golanovas/Diplom-Help/02_Аннотация.docx

АННОТАЦИЯ

Выпускная квалификационная работа посвящена разработке устройства защиты помещения от затопления и протечек, которое позволяет пользователю предотвращать негативные последствия несанкционированного выливания воды. Также оно оповещает пользователя о выполненных операциях, позволяя своевременно реагировать на возникшую протечку.

Так же работа включает в себя комплекс документов по разработке устройства. Содержание графической части: схема электрическая структурная, схема электрическая принципиальная, алгоритм работы устройства, чертеж печатной платы, сборочный чертеж электронной ячейки, сборочный чертеж устройства, спецификации, схемы сборки. В заключении представлены выводы о проделанной работе и соответствии разработанного устройства техническому заданию.

Ключевые слова: протечка, затопление, оповещение, схемотехническое проектирование, конструкторское проектирование, технологическое проектирование.

ABSTRACT

The final qualifying work is devoted to the development of a device for protecting a room from flooding and leaks, which allows the user to prevent the negative consequences of unauthorized pouring of water. It also notifies the user of completed operations, allowing them to respond in a timely manner to a leak.

The work also includes a set of documents on the development of the device. The contents of the graphic part are: an electrical structural diagram, an electrical schematic diagram, an algorithm for the operation of the device, a drawing of a printed circuit board, an assembly drawing of an electronic cell, an assembly drawing of the device, specifications, assembly diagrams. In conclusion, the conclusions about the work done and the compliance of the developed device with the technical specification are presented.

Keywords: leakage, flooding, notification, circuit engineering, design engineering, technological design.
