golanovas/Diplom-Help/01_Титульный лист.docx

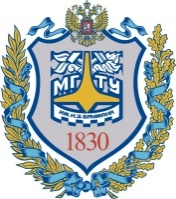
[picture p1: figure]
Gerb-BMSTU_01

| Министерство науки и высшего образования Российской Федерации Федеральное государственное бюджетное образовательное учреждение высшего образования «Московский государственный технический университет имени Н.Э. Баумана (национальный исследовательский университет)» (МГТУ им. Н.Э. Баумана)

ФАКУЛЬТЕТ Информатика и системы управления .

КАФЕДРА Проектирование и технология производства электронной аппаратуры .

РАСЧЕТНО-ПОЯСНИТЕЛЬНАЯ ЗАПИСКА

К ВЫПУСКНОЙ КВАЛИФИКАЦИОННОЙ РАБОТЕ

НА ТЕМУ:

Устройство защиты помещения от затопления и протечек

Студент ИУ4-71Б _________________ С.А. Глухов .

(Группа) (Подпись, дата) (И.О.Фамилия)

Руководитель ВКР _________________ А.Е. Курносенко .

(Подпись, дата) (И.О.Фамилия)

Консультант _________________ ____________________

(Подпись, дата) (И.О.Фамилия)

Консультант _________________ ____________________

(Подпись, дата) (И.О.Фамилия)

Нормоконтролер _________________ ____________________

(Подпись, дата) (И.О.Фамилия)

2024 г.
