golanovas/Diplom-Help/03_Содержание.docx

СОДЕРЖАНИЕ

УСЛОВНЫЕ ОБОЗНАЧЕНИЯ, СОКРАЩЕНИЯ И ЬЕРМИНЫ

ВВЕДЕНИЕ

1. ТЕХНИКО-ЭКОНОМИЧЕСКОЕ ОБОСНОВАНИЕ РАЗРАБОТКИ УСТРОЙСТВА ЗАЩИТЫ ПОМЕЩЕНИЯ ОТ ЗАТОПЛЕНИ И ПРОТЕЧЕК
  1.1. Анализ существующих на рынке устройств
  1.2. Анализ необходимых функций разрабатываемого устройства
  1.3. Анализ характеристик разрабатываемого устройства

Выводы

2. СХЕМОТЕХНИЧЕСКОЕ ПРОЕКТИРОВАНИЕ ЭЛЕКТРОННОЙ ЯЧЕЙКИ УСТРОЙСТВА ЗАЩИТЫ ПОМЕЩЕНИЯ ОТ ЗАТОПЛЕНИЯ И ПРОТЕЧЕК
  2.1. Разработка схемы электрической структурной электронной ячейки устройства защиты помещения от затопления и протечек
  2.2. Разработка схемы электрической принципиальной электронной ячейки устройства защиты помещения от затопления и протечек
  2.3. Расчёт потребляемой устройством защиты помещения от затопления и протечек мощности
  2.4. Выбор и анализ элементной базы устройства защиты помещения от затопления и протечек
  2.5. Выбор и анализ элементной базы устройства защиты помещения от затопления и протечек

Выводы

3. РАЗРАБОТКА ПРОГРАММНОГО ОБЕСПЕЧЕНИЯ УСТРОЙСТВА ЗАЩИТЫ ПОМЕЩЕНИЯ ОТ ЗАТОПЛЕНИЯ И ПРОТЕЧЕК
  3.1. Постановка задач разработки программного обеспечения устройства защиты помещения от затопления и протечек
  3.2. Разработка диаграммы состояний устройства защиты помещения от затопления и протечек
  3.3. Разработка диаграммы вариантов использования устройства защиты помещения от затопления и протечек
  3.4. Разработка временной диаграммы GPIO выводов микроконтроллера устройства защиты помещения от затопления и протечек
  3.5. Разработка алгоритма работы устройства защиты помещения от затопления и протечек

Выводы

4. КОНСТРУКТОРСКОЕ ПРОЕКТИРОВАНИЕ УСТРОЙСТВА ЗАЩИТЫ ПОМЕЩЕНИЯ ОТ ЗАТОПЛЕНИЯ И ПРОТЕЧЕК
  4.1. Выбор электрических соединений устройства защиты помещения от затопления и протечек
  4.2. Выбор материалов печатной платы электронной ячейки устройства защиты помещения от затопления и протечек
  4.3. Расчёт параметров элементов проводящего рисунка печатной платы электронной ячейки устройства защиты помещения от затопления и протечек
  4.4. Разработка топологии печатной платы электронной ячейки устройства защиты помещения от затопления и протечек
  4.5. Проектирование электронной ячейки устройства защиты помещения от затопления и протечек
  4.6. Выбор аккумуляторов устройства защиты помещения от затопления и протечек
  4.7. Выбор конструкции и материала корпуса устройства защиты помещения от затопления и протечек
  4.8. Выбор механических соединений устройства защиты помещения от затопления и протечек
  4.9. Выбор механических соединений устройства защиты помещения от затопления и протечек
  4.10. Проектирование устройства защиты помещения от затопления и протечек
  4.11. Анализ теплового режима
  4.12. Анализ механических воздействий
  4.13. Расчёт надёжности

Выводы

5. ТЕХНОЛОГИЧЕСКОЕ ПРОЕКТИРОВАНИЕ УСТРОЙСТВА ЗАЩИТЫ ПОМЕЩЕНИЯ ОТ ЗАТОПЛЕНИЯ И ПРОТЕЧЕК
  5.1. Анализ конструкции устройства защиты помещения от затопления и протечек
  5.2. Анализ сборочного состава электронной ячейки устройства защиты помещения от затопления и протечек
  5.3. Анализ сборочного состава устройства защиты помещения от затопления и протечек
  5.4. Разработка схемы сборки устройства защиты помещения от затопления и протечек
  5.5. Расчёт и анализ такта выпуска устройства защиты помещения от затопления и протечек
  5.6. Разработка маршрута сборки устройства защиты помещения от затопления и протечек

Выводы

6. ИССЛЕДОВАТЕЛЬСКИЕ ИСПЫТАНИЯ ОПЫТНОГО ОБРАЗЦА УСТРОЙСТВА ЗАЩИТЫ ПОМЕЩЕНИЯ ОТ ЗАТОПЛЕНИЯ И ПРОТЕЧЕК
  6.1. Постановка задач исследовательских испытаний опытного образца устройства защиты помещения от затопления и протечек
  6.2. Исследование работоспособности опытного образца устройства защиты помещения от затопления и протечек при питании от сети и аккумуляторов
  6.3. Исследование стабильности номиналов питания опытного образца устройства защиты помещения от затопления и протечек
  6.4. Исследование корректности алгоритма работы опытного образца устройства защиты помещения от затопления и протечек
  6.5. Исследование работоспособности пользовательского интерфейса опытного образца устройства защиты помещения от затопления и протечек
  6.6. Исследование теплового режима опытного образца устройства защиты помещения от затопления и протечек

Выводы

ЗАКЛЮЧЕНИЕ

СПИСОК ИСПОЛЬЗОВАННЫХ ИСТОЧНИКОВ

ПРИЛОЖЕНИЕ А

ПРИЛОЖЕНИЕ Б

ПРИЛОЖЕНИЕ В
