golanovas/Diplom-Help/04_Условные обозначения, сокращения и термины.docx

# УСЛОВНЫЕ ОБОЗНАЧЕНИЯ, СОКРАЩЕНИЯ И ТЕРМИНЫ

ГОСТ – Государственный стандарт;

ДПП – Двухсторонняя печатная плата;

ЕСКД – Единая система конструкторской документации;

КМО – Компонент, монтируемый в отверстие;

КМП – Компонент, монтируемый на поверхность;

МК – Микроконтроллер;

ПО – Программное обеспечение;

ПП – Печатная плата;

РПЗ – Расчётно-пояснительная записка;

РТЗ – Расширенное техническое задание;

ТЗ – Техническое задание;

УЗПЗП – Устройство защиты помещения от затопления и протечек;

ЭРЭ – Электрорадиоэлементы;

ABS – Ударопрочная техническая термопластическая смола на основе сополимера акрилонитрила с бутадиеном и стиролом;
