golanovas/Diplom-Help/05_Введение.docx

ВВЕДЕНИЕ

Во время несанкционированного выливания большого объёма воды в помещении, которое может произойти как от протечки в водном контуре или незакрытого крана, так и от плохого состояния стен или крыши в загородных домах или складских помещениях, может быть нанесён существенный вред. Например, во время затоплений в многоквартирных домах, кроме затапливаемой квартиры страдает также помещения снизу.

Для предотвращения подобных случаев, необходимо наличие устройства, которое могло бы оповещать о случаях выливания воды, а также стараться ограничивать дальнейшее увеличение вылитого объёма.

Работа посвящена разработке устройства защиты помещения от затопления и протечек (УЗПЗП).

Актуальность работы заключается в востребованности разработки и внедрения доступного устройства, объединяющего в себе функции обнаружения вылитой воды, оповещение пользователя и устранения вылитой воды не только с помощью закрытия кранов между внешним и внутренним водяными контурами, но и удаление воды из внутреннего водяного контура.

Цель работы – разработать устройство, отслеживающее состояние датчиков протечки и реагирующее на появление вылитой воды. Устройство должно обладать компактными размерами, что обеспечит удобство его размещения в ограниченном пространстве, а также быть оснащённым механизмом или крепёжными элементами, позволяющими надёжно фиксировать его на вертикальной поверхности — например, на стене или перегородке. Такая конструкция позволит рационально использовать доступную площадь и обеспечит устойчивое положение устройства в рабочем состоянии. В качестве пользовательского интерфейса взаимодействия с устройством должен использоваться Telegram бот.

Для решения постановленной задачи были выполнены следующие работы:

- Проведение схемотехнического проектирования электронной ячейки УЗПЗП, в рамках которой разрабатываются: схема электрическая структурная и схема электрическая принципиальная;
- Разработка ПО микроконтроллера УЗПЗП, включающее в себя разработку алгоритма работы УЗПЗП, а также его реализацию с помощью программы на языке C++;
- Проведение конструкторского проектирования УЗПЗП, в рамках которого были разработаны топология печатная плата электронной ячейки, модель электронной ячейки, корпус и модель всего устройства. Также были проведены моделирования и расчёты тепловых режимов работы, механических воздействий и надёжности УЗПЗП;
- Проведение технологического проектирования УЗПЗП, в рамках которого были разработаны схема сборки и маршрут сборки устройства, а также рассчитаны такт выпуска и коэффициент технологичности электронной ячейки;
- Изготовление опытного образца УЗПЗП, а также проведение исследовательских испытаний для определения границ его работоспособности.

Исходными данными являются:

- ТЗ на выполнение ВКРБ;
- Календарный план выполнения ВКРБ.

Результатом работы является набор расчетной и графической документации. В ее состав входят: схема электрическая структурная (Э1), схема электрическая принципиальная ультразвукового сканера (Э3), перечень элементов (ПЭ3), алгоритм работы и его реализация в виде ПО для микроконтроллера, чертеж печатной платы ультразвукового сканера, сборочный чертеж электронной ячейки ультразвукового сканера, спецификация на электронную ячейку, сборочный чертёж УЗПЗП, спецификация УЗПЗП, опытный образец УЗПЗП, РПЗ.

Структура и объём работы. Работа состоит из шести разделов. В первом разделе обосновывается необходимость разработки УЗПЗП. Во втором разделе изложены результаты схемотехнического проектирования устройства. Третий раздел посвящён описанию программного обеспечения, разработанного для микроконтроллера УЗПЗП. В четвёртом разделе представлена конструкторская разработка УЗПЗП, включая моделирование и расчёт основных параметров его работы. Пятый раздел содержит результаты технологического проектирования устройства, а также описан разработанный технологический процесс его изготовления. Шестой раздел посвящён экспериментальному исследованию опытного образца УЗПЗП.
