golanovas/Diplom-Help/12_Заключение.docx

ЗАКЛЮЧЕНИЕ

В процессе выполнения выпускной квалификационной работы было проведено комплексное исследование и разработка устройства защиты помещения от затопления и протечек, включающее анализ технических требований, проектирование аппаратной и программной части, конструкторские и технологические расчёты, а также изготовление и экспериментальное исследование опытного образца.

На начальном этапе были определены основные функциональные требования к устройству, а также условия эксплуатации. Проведён обзор существующих аналогов, позволивший обосновать целесообразность создания нового решения, объединяющего функции обнаружения протечки, автоматического перекрытия воды, удаления остатков жидкости с помощью насоса и информирования пользователя через Telegram-бота.

В рамках схемотехнического проектирования разработаны электрическая структурная и принципиальная схемы электронной ячейки устройства. Был выполнен расчёт потребляемой мощности, произведён выбор элементной базы и проведён её анализ на соответствие заданным режимам работы.

Программное обеспечение микроконтроллера было реализовано на основе алгоритма, разработанного из диаграммы состояний, диаграммы вариантов использования и временных диаграмм выводов микроконтроллера. Это позволило обеспечить корректную работу всех функциональных узлов устройства, включая считывание показаний датчиков протечки и управление исполнительными механизмами.

На этапе конструкторского проектирования была разработана топология печатной платы, рассчитаны параметры проводящего рисунка и выбраны материалы для изготовления платы, соответствующие действующим стандартам. Также были определены конструктивные особенности устройства, включая выбор корпуса, способов крепления и механических соединений. Выполнены тепловой расчёт, расчёт на воздействие механических нагрузок и оценка надёжности, подтвердившие работоспособность УЗПЗП в условиях реальной эксплуатации.

Технологическое проектирование включало разработку маршрута и схемы сборки устройства, расчёт такта выпуска и коэффициента технологичности. Результаты показали возможность эффективного производства устройства в мелкосерийном режиме без значительных изменений в технологии.

В заключение был изготовлен опытный образец устройства, на котором проведены исследовательские испытания, подтвердившие его работоспособность при питании как от сети, так и от аккумуляторов. Проверена стабильность номиналов питания, корректность алгоритма работы, функционирование пользовательского интерфейса и тепловой режим устройства.

Все этапы проекта — от анализа требований до экспериментального подтверждения работоспособности — выполнены в соответствии с техническим заданием. Разработанное устройство защиты помещения от затопления и протечек полностью соответствует заявленным характеристикам.
