golanovas/Diplom-Help/13_Список литературы.docx

СПИСОК ИСПОЛЬЗОВАННЫХ ИСТОЧНИКОВ

1. ООО "Биосе". Автономный сигнализатор протечки воды [Электронный ресурс] . — URL: https://biose.ru/catalog/nasha_produktsiya/ avtonomnyy_signalizator_protechki_vody_biose.html (дата обращения: 05.04.2025).
2. Сиблинг — Датчик протечки [Электронный ресурс] . — Режим доступа: URL: https://sibling.ru/all/security/kontrol-protechki-100/datchik-protechki-108/datchik-protechki-89/ (дата обращения: 05.04.2025).
3. Нептун. Официальный сайт — [Электронный ресурс] . — Режим доступа: URL: https://neptunsale.ru/ (дата обращения: 05.04.2025).
4. Биосе — Блокиратор протечек воды «Акваблок Золушка» [Электронный ресурс] . — Режим доступа: URL: https://biose.ru/catalog/nasha_produktsiya/blokirator_protechek_ vody_akvablok_zolushka.html (дата обращения: 05.04.2025).
5. ГОСТ 15150–69. Машины, приборы и другие технические изделия. Исполнения для различных климатических районов. Категории, условия эксплуатации, хранения и транспортирования в части воздействия климатических факторов внешней среды. — М.: Издательство стандартов, 1969. — 24 с.
6. ГОСТ 2.701–2008. Единая система конструкторской документации. Схемы. Виды и типы. Общие требования к выполнению. — М.: Стандартинформ, 2008. — 11 с.
7. ГОСТ 2.702–2011. Единая система конструкторской документации. Правила выполнения электрических схем. — М.: Стандартинформ, 2011. — 13 с.
8. Монк, С. Электроника. Теория и практика : учебник / С. Монк ; пер. с англ. П. Шерц. — 4-е изд. — СПб. : БХВ-Петербург, 2018. — 1168 с. : ил.
9. Титце, У., Шенк, К. Полупроводниковая схемотехника : учебник / У. Титце, К. Шенк ; пер. с нем. — 12-е изд. — Том I. — М. : ДМК Пресс, [без года]. — 832 с. : ил.
10. Aerosemi Technology — MT3608: High Efficiency 1.2MHz 2A Step Up Converter [Электронный ресурс] : техническое описание. — Режим доступа: URL: https://static.chipdip.ru/lib/688/DOC045688395.pdf (дата обращения: 05.04.2025).
11. Хоровиц, П., Хилл, У. Искусство схемотехники. Том I : учебное пособие / П. Хоровиц, У. Хилл ; пер. с англ. — 3-е изд. — М. : Техносфера, 2021. — 768 с.
12. ГОСТ 19.701–90. Единая система программной документации. Схемы алгоритмов и программ. Обозначения условные графических примитивов. — М.: Издательство стандартов, 1990. — 26 с.
13. Пирогова, Е. В. Проектирование и технология печатных плат : учебник для вузов / Е. В. Пирогова. — М. : ФОРУМ : ИНФРА-М, 2005. — 559 с. : ил.
14. ГОСТ 53429–2009. Совместимость техническая электромагнитная. Устройства защиты от импульсных перенапряжений низковольтные. Требования и методы испытаний. — М.: Стандартинформ, 2010. — 24 с.
15. ГОСТ 9.301–86. Единая система защиты от коррозии и старения. Покрытия металлические и неметаллические неорганические. Общие требования и методы ускоренных испытаний на стойкость к коррозии. — М.: Издательство стандартов, 1986. — 23 с.
16. ГОСТ 14526–93. Системы автоматического пожарного оповещения. Классификация и общие технические требования. — М.: Издательство стандартов, 1993. — 17 с.
17. ГОСТ Р 54849–2011 (IPC-SM-840E:2010). Национальный стандарт Российской Федерации. Маска паяльная защитная для печатных плат. Общие технические условия. — М.: Стандартинформ, 2011. — 10 с.ГОСТ 18620–86. Электромонтажные изделия. Общие технические условия. — М.: Издательство стандартов, 1986. — 7 с.
18. ГОСТ 18620–86. Изделия электротехнические. Маркировка. — М.: Издательство стандартов, 1986. — 7 с.
19. ТУ 29-02-889–93. Краски трафаретные серии 45971 для невпитывающих поверхностей. Технические условия. — М., 1993. — 12 с.
20. ГОСТ 23752–79. Платы печатные. Общие технические условия. — М.: Госстандарт, 1979. — 16 с.
21. ГОСТ Р МЭК 61192-1–2010. Печатные узлы. Требования к качеству. Часть 1. Общие технические требования. — М.: Стандартинформ, 2011. — 18 с.
22. ГОСТ Р 59630–2021. Установка поверхностно-монтируемых изделий на печатные платы. Методы конструирования. — М.: Стандартинформ, 2021. — 12 с.
23. ГОСТ Р 59681–2021. Сборка и монтаж электронных модулей. Припои, флюсы для пайки, припойные пасты. Марки, состав, свойства и область применения. — М.: Стандартинформ, 2021. — 24 с.
24. ГОСТ Р МЭК 61192-2–2010. Печатные узлы. Требования к качеству. Часть 2. Поверхностный монтаж. — М.: Стандартинформ, 2011. — 20 с.
25. ГОСТ 29137–91. Формовка выводов и установка изделий электронной техники на печатные платы. Общие требования и нормы конструирования. — М.: Издательство стандартов, 1991. — 14 с.
26. ГОСТ Р 56427–2022. Электронные модули радиоэлектронных средств. Технические требования к выполнению технологических операций пайки при поверхностном монтаже, монтаже в сквозные отверстия и смешанном монтаже с применением бессвинцовой и традиционной технологий. — М.: Стандартинформ, 2022. — 16 с.
27. ТУ 2389-001-78983067-05. Пластины из полимерных материалов "PLASTIK-71". Технические условия. — [М.], 2005. — 8 с.
28. ГОСТ 16019–2001. Аппаратура сухопутной подвижной радиосвязи. Требования по стойкости к воздействию механических и климатических факторов и методы испытаний. — М.: Госстандарт, 2001. — 14 с.
