golanovas/Diplom-Help/Голанов А.С. ИУ4-82Б ВКРБ РТЗ.docx

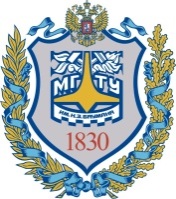
[picture p26: figure]
Gerb-BMSTU_01

| Министерство науки и высшего образования Российской Федерации Федеральное государственное автономное образовательное учреждение высшего образования «Московский государственный технический университет имени Н.Э. Баумана (национальный исследовательский университет)» (МГТУ им. Н.Э. Баумана)

ФАКУЛЬТЕТ «Информатика и системы управления» («ИУ»)

КАФЕДРА «Проектирование и технология производства электронной аппаратуры» («ИУ-4»)

РАСШИРЕННОЕ ТЕХНИЧЕСКОЕ ЗАДАНИЕ

НА ВЫПОЛНЕНИЕ ВЫПУСКНОЙ КВАЛИФИКАЦИОННОЙ РАБОТЫ БАКАЛАВРА:

Тема выпускной работы: «Система позиционирования в помещении»

Студент группы ИУ4-82Б А.С. Голанов

(Подпись, дата)

Руководитель ВКР А.В. Лавров

(Подпись, дата)

РАСШИРЕННОЕ ТЕХНИЧЕСКОЕ ЗАДАНИЕ

Настоящее техническое задание распространяется на разработку и исследование системы позиционирования в помещении на основе сверхширокополосной технологии, предназначенной для определения координат мобильного устройства в закрытых пространствах.

1. НАИМЕНОВАНИЕ, НАЗНАЧЕНИЕ И ОБЛАСТЬ ПРИМЕНЕНИЯ СИСТЕМЫ ПОЗИЦИОНИРОВАНИЯ В ПОМЕЩЕНИИ

1.1. Наименование изделия – система позиционирования в помещении

1.2. Система позиционирования в помещении предназначена для определения координат (x, y) мобильного устройства в реальном времени с использованием трех фиксированных базовых станций, на основе измерения времени пролета сигнала (ToF) в сверхширокополосном диапазоне.

1.3. Система позиционирования в помещении может быть использована для навигации роботов в складах, трекинга активов в логистике, мониторинга пациентов в здравоохранении или интеграции в IoT-системы для умных помещений.

2. ОСНОВАНИЕ ДЛЯ РАЗРАБОТКИ СИСТЕМЫ ПОЗИЦИОНИРОВАНИЯ В ПОМЕЩЕНИИ
  2.1. Настоящее техническое задание разработано в соответствии с заданием на квалификационную работу бакалавра.
3. ЦЕЛЬ И НАЗНАЧЕНИЕ РАЗРАБОТКИ СИСТЕМЫ ПОЗИЦИОНИРОВАНИЯ В ПОМЕЩЕНИИ
  3.1. Цель разработки – создание макетного образца изделия и комплект конструкторской и схемотехнической документации к нему.
  3.2. Система позиционирования должна иметь сетевое питание и работать в климатических условиях УХЛ4.1 по ГОСТ 15150-69.
4. ИСТОЧНИКИ РАЗРАБОТКИ АДАПТИВНОГО ТОРГОВОГО АВТОМАТА
  4.1. Анализ источников информации об аналогах по назначению.
5. ТЕХНИЧЕСКИЕ ТРЕБОВАНИЯ СИСТЕМЫ ПОЗИЦИОНИРОВАНИЯ В ПОМЕЩЕНИИ

5.1. Состав изделия системы позиционирования в помещении

5.1.1 Разрабатываемое устройство системы позиционирования в помещении состоит из электронной ячейки (для базовых станций и мобильного устройства) и корпуса.

5.1.2 Устройство предназначено для обмена сверхширокополосными сигналами между базовыми станциями и мобильным устройством, расчета расстояний по ToF и определения позиции с использованием алгоритма трилатерации.

5.2. Технические параметры системы позиционирования в помещении

Основные технические показатели изделия:

- напряжение питания управляющей платы: постоянное 3,3 В ± 5%;
- максимальный ток до 100 мА (в активном режиме);
- напряжение работы микроконтроллера 3,3 В ± 5%;
- диапазон рабочих температур: от 0°С до +40°С.
- максимальная дальность позиционирования — до 50 м;
- анализируемый частотный диапазон — 3,1–10,6 ГГц (полоса не менее 500 МГц);
- точность позиционирования — 10–30 см;
- количество базовых станций — 3 (фиксированные);
- количество режимов работы — до 2 (стандартный и энергосберегающий). Также устройство должно иметь возможность вывода данных через USB-интерфейс для конфигурации и мониторинга.

5.3. Требования к надежности системы позиционирования в помещении

Вероятность безотказной работы составляет 0,95 за время 10000 ч. Установленный срок службы изделия – 2 года.

5.4. Требования к уровню унификации и стандартизации

Требования к уровню унификации и стандартизации не предъявляются.

5.5. Конструктивные требования к системе позиционирования в помещении

5.5.1 Разрабатываемое устройство состоит из двухсторонней печатной платы с ЭРЭ и ИЭТ. Габариты базовой станции не более 100×100×50 мм, габариты мобильного устройства не более 80×60×30 мм, общая масса не более 0,2 кг.

5.5.2 Устройство питается от литий-ионного аккумулятора на 3,3 В или внешнего источника, подключенного через USB Type-C.

5.6. Условия эксплуатации системы позиционирования в помещении

Условия эксплуатации устройства соответствуют стационарной электронной аппаратуре для работы в закрытых отапливаемых и/или вентилируемых помещениях. Разрабатываемая система позиционирования в помещении должна соответствовать требованиям технического задания при воздействии следующих условий:

1. Условия эксплуатации в части воздействия механических факторов внешней среды: a) вибрация:
- диапазон частот: 20...4000 Гц;
- максимальное ускорение: 0.5g;
- длительность ударного импульса: 10 мс;
- амплитуда ускорения ударного импульса: 10g.
2. Климатические условия эксплуатации:

a) климатическое исполнение изделия: УХЛ4.1 по ГОСТ 15150-69;

b) температура воздуха при эксплуатации: от 0°С до +40°С;

c) атмосферное давление не превышает: 105 кПа;

d) Влажность воздуха: не более 80% при 25 °С.

5.7. Требования к составным частям, сырью и исходным материалам

Не предъявляются.

5.8. Требования к упаковке, маркировке, транспортированию и хранению системы позиционирования в помещении

Транспортирование упакованных устройств производиться любым видом транспорта. Транспортирование может производиться в закрытых железнодорожных вагонах или контейнерах, автомашинах, отапливаемых и герметизированных отсеках самолетов при соблюдении требований хранения настоящего ТЗ.

1. Условия транспортировки в части воздействия:

a) Механических нагрузок - группе "С" по ГОСТ23216-78;

b) Климатических факторов - группе 2 ("С") по ГОСТ 15150-69.

2. Условия хранения в части воздействия климатических факторов: группе 1 ("Л") по ГОСТ 15150-69. Система позиционирования в помещении должна храниться в сухом помещении. В помещении для хранения не должно быть паров кислот и щелочей, а также газов, вызывающих коррозию и разрушающих изоляцию.

5.9. Требования к патентной чистоте

Патентная чистота системы позиционирования в помещении должна быть обеспечена в отношении Российской федерации и стран СНГ.

6. ЭКОНОМИЧЕСКИЕ ПОКАЗАТЕЛИ СИСТЕМЫ ПОЗИЦИОНИРОВАНИЯ В ПОМЕЩЕНИИ

6.1. По сравнению с источниками разработки предлагаемое изделие имеет ряд экономических преимуществ:

- используются более распространенные и дешевые ЭРЭ;
- компактный размер;
- низкое энергопотребление.
7. ТРЕБОВАНИЯ ПО ТЕХНИКЕ БЕЗОПАСНОСТИ И ЭКОЛОГИЧЕСКОЙ ЗАЩИТЕ

7.1. Разрабатываемое изделие при эксплуатации должно обеспечивать безопасность обслуживающего персонала от поражения электрическим током согласно ГОСТ Р 51350-99.

7.2. Требования по охране природы не предъявляются, так как при изготовлении, эксплуатации, транспортировании, хранении, утилизации устройства отсутствуют вредные воздействия на элементы окружающей среды – воздух, воду, почву, недра, растительный и животный мир.

8. ПОРЯДОК КОНТРОЛЯ И ПРИЁМКИ СИСТЕМЫ ПОЗИЦИОНИРОВАНИЯ В ПОМЕЩЕНИИ

8.1 Для приемки предоставляется один опытный образец системы позиционирования в помещении, эксплуатационная документация, методика приемных испытаний, согласованная в установленном порядке.

8.2 Конструкторская документация должна быть разработана в соответствии с требованиями ГОСТов ЕСКД, согласована и утверждена в установленном порядке.

8.3 По результатам проведения приемных испытаний (при необходимости) проводится корректировка конструкторской документации (в том числе эксплуатационной).

8.4 Отдельные требования настоящего технического задания могут изменяться и дополняться по согласованию сторон в установленном порядке.
