golanovas/Diplom-Help/Голанов_ПЭ3.docx

Поз. обозначение | | | | Наименование | | | Кол. | | Примечание
| | | | Резисторы
R1 – R5, R10 | | | | RC0603FR-07470RL 470 Ом ±5% | | | 6
| | | | (Yageo)
R6, R7, R9, R15 – R20 | | | | RC1206JR-071KL 10 кОм ±5% | | | 10
| | | | (Yageo)
R8, R11 – R14 | | | | RC0603FR-071KL 1 кОм ±5% | | | 5
| | | | (Yageo)
| | | | Конденсаторы
С1, C5, C6, C9 | | | | GRM188R71H103K01D 10 нФ 50В 10% | | | 4
| | | | (Murata)
C2, С8, C12 | | | | CL10B104KB8NNNC 100 нФ 50 В 10% | | | 3
| | | | (Murata)
C3, C4, C7, C10 | | | | CC0603KRX5R7BB106 10 мкФ 50 В 10% | | | 4
| | | | (Murata)
C11, С13, С14 | | | | GRM188R61A105K 1 мкФ 50 В 10% | | | 3
| | | | (Murata)
| | | | Транзисторы
VT1,VT2 | | | | S8050 NPN 25В 0.1А 0.3Вт | | | 2
| | | | (Hottech)
| | | | Диоды
VD1 | | | | B5819WS 40В 1А | | | 1
| | | | (Китай)
| | | | | | ИУ4.11.03.03.26.08.82.07.001 ПЭ3
Изм. | Лист | № докум. | Подп. | | Дата
Разраб. | | Голанов А.С. | | | | Система позиционирования в помещении Перечень элементов | | Лит. | | | Лист | Листов
Пров. | | Лавров А.В. | | | | | | | | | 1 | 2
| | | | | | | | МГТУ им. Н.Э. Баумана Кафедра ИУ4 Группа ИУ4-82Б
Н. контр.
Утв.

Поз. обозначение | | | Наименование | | | Кол. | Примеч.
| | | Светодиоды
HL1-HL5 | | | Светодиод зелёный FYLS-0805PGC | | | 5
| | | (Китай)
| | | Стабилизаторы напряжения
DA1 | | | AP2112K-3.3TRG1 Uвых=3.3В, 0.6А | | | 1
| | | (Diodes Inc.)
DA2 | | | LD1117/3.3v Uвых=3.3В, 1А | | | 1
| | | (Youtai Semiconductor)
| | | Микросхемы
DD1 | | | Преобразователь USB-UARTCP2104-F03-GMR | | | 1
| | | (Silicon Labors)
DD2 | | | Модуль позиционирования DWM1000 BU01 | | | 1
| | | (Jessine)
DD3 | | | Микроконтроллер ESP-WROOM-32 | | | 1
| | | (ESPRESSIF)
| | | Переключатели
SW1, SW2 | | | Кнопка тактовая KLS7-TS6604-5.0-180 | | | 2
| | | (KLS)
| | | Разъёмы
XP1 | | | Вилка штыревая 2.54мм 1x20 PLS-20 | | | 1
| | | (Connfly)
XP2 | | | Вилка штыревая 2.54мм 1x12 PLS-12 | | | 1
| | | (Connfly)
XP3 | | | Разъём Micro USB Типа B 105017-1001 | | | 1
| | | (Molex)
| | | | | ИУ4.11.03.03.26.08.82.07.001 ПЭ3 | | | Лист
| | | | | | | | 2
Изм | Лист | № докум. | Подп. | Дата
