golanovas/Diplom-Help/Голанов_СП_Ячейки.docx

Форм. | Зона | | Поз. | Обозначение | | | | Наименование | | | | | Кол. | | Примеч.
| | | | | | | | Документация
А3 | | | | ИУ4.11.03.03.26.08.82.07.000 СБ | | | | Сборочный чертеж | | | | | 1
| | | | | | | | Детали
А3 | | | 1 | ИУ4.11.03.03.26.08.82.07.001 СБ | | | | Система позиционирования в помещении | | | | | 1
A3 | | | 2 | ИУ4.11.03.03.26.08.82.07.000 | | | | Корпус в сборе
| | | | | | | | Стандартные изделия
| | | 3 | | | | | Винт М3-6gx6 ГОСТ 17473-80 | | | | | 12
| | | | | | | ИУ4.11.03.03.26.08.82.07.001 СП
Изм | | Лист | | № докум. | Подп. | Дата
Разраб. | | | | Голанов А.С. | | | Система позиционирования в помещении Спецификация | | Лит. | | | Лист | | Листов
Пров. | | | | Лавров А.В. | | | | | | | | | | 1
| | | | | | | | | МГТУ им Н. Э. Баумана Кафедра ИУ4 Группа ИУ4–82 Б
Н.контр.
Утв.

fdfddf
