golanovas/Diplom-Help/Голанов_А.С._ИУ4-82Б_ВКРБ_Э1.pdf

Инв. № подл. Инв. № дубл. Подп. и дата Взам. инв. № Подп. и дата Перв. примен. Справ. №

2.106-A3

Копировал

Н.контр.
Утв.
Формат А3
| | | | | ИУ4.11.03.03.25.82.07.001 Э1
| | | | | Система позиционирования в помещении Схема электрическая структурная | Лит. | Масса | Масштаб
Изм. | Лист | № докум. | Подп. | Дата
Разраб. | | Голанов А.С.
Пров. | | Лавров А.В.
Т.контр. | | | | | Лист 2 | Листов 3 1
| | | | | МГТУ им. Н.Э. Баумана Кафедра ИУ4 Группа ИУ4-82Б

# Микроконтроллер ESP-WROOM-32

# Модуль

BU01

# приёмопередатчик

# Питание +5В

# Сигнал 6.5ГГц micro-USB порт
