golanovas/Diplom-Help/Голанов_А.С._ИУ4-82Б_ВКРБ_Э2.pdf

Инв. № подл. Инв. № дубл. Подп. и дата Взам. инв. № Подп. и дата Перв. примен. Справ. №

2.106-A3

Копировал

Н.контр.
Утв.
Формат А3
| | | | | ИУ4.11.03.03.25.82.07.001 Э2
| | | | | Система позиционирования в помещении Схема электрическая функциональная | Лит. | Масса | Масштаб
Изм. | Лист | № докум. | Подп. | Дата
Разраб. | | Голанов А.С.
Пров. | | Лавров А.В.
Т.контр. | | | | | Лист 3 | Листов 3 1
| | | | | МГТУ им. Н.Э. Баумана Кафедра ИУ4 Группа ИУ4-82Б

Микроконтроллер
ESP-WROOM-32

Модуль
BUO1
Сигнал 6.5ГГц | приёмопередатчик

Светоиндикатор
питания

+3.3В

Стабилизатор
напряжения

Питание +5В

micro-USB порт
