golanovas/Diplom-Help/Голанов_А.С._ИУ4-82Б_ВКРБ_Э3.pdf

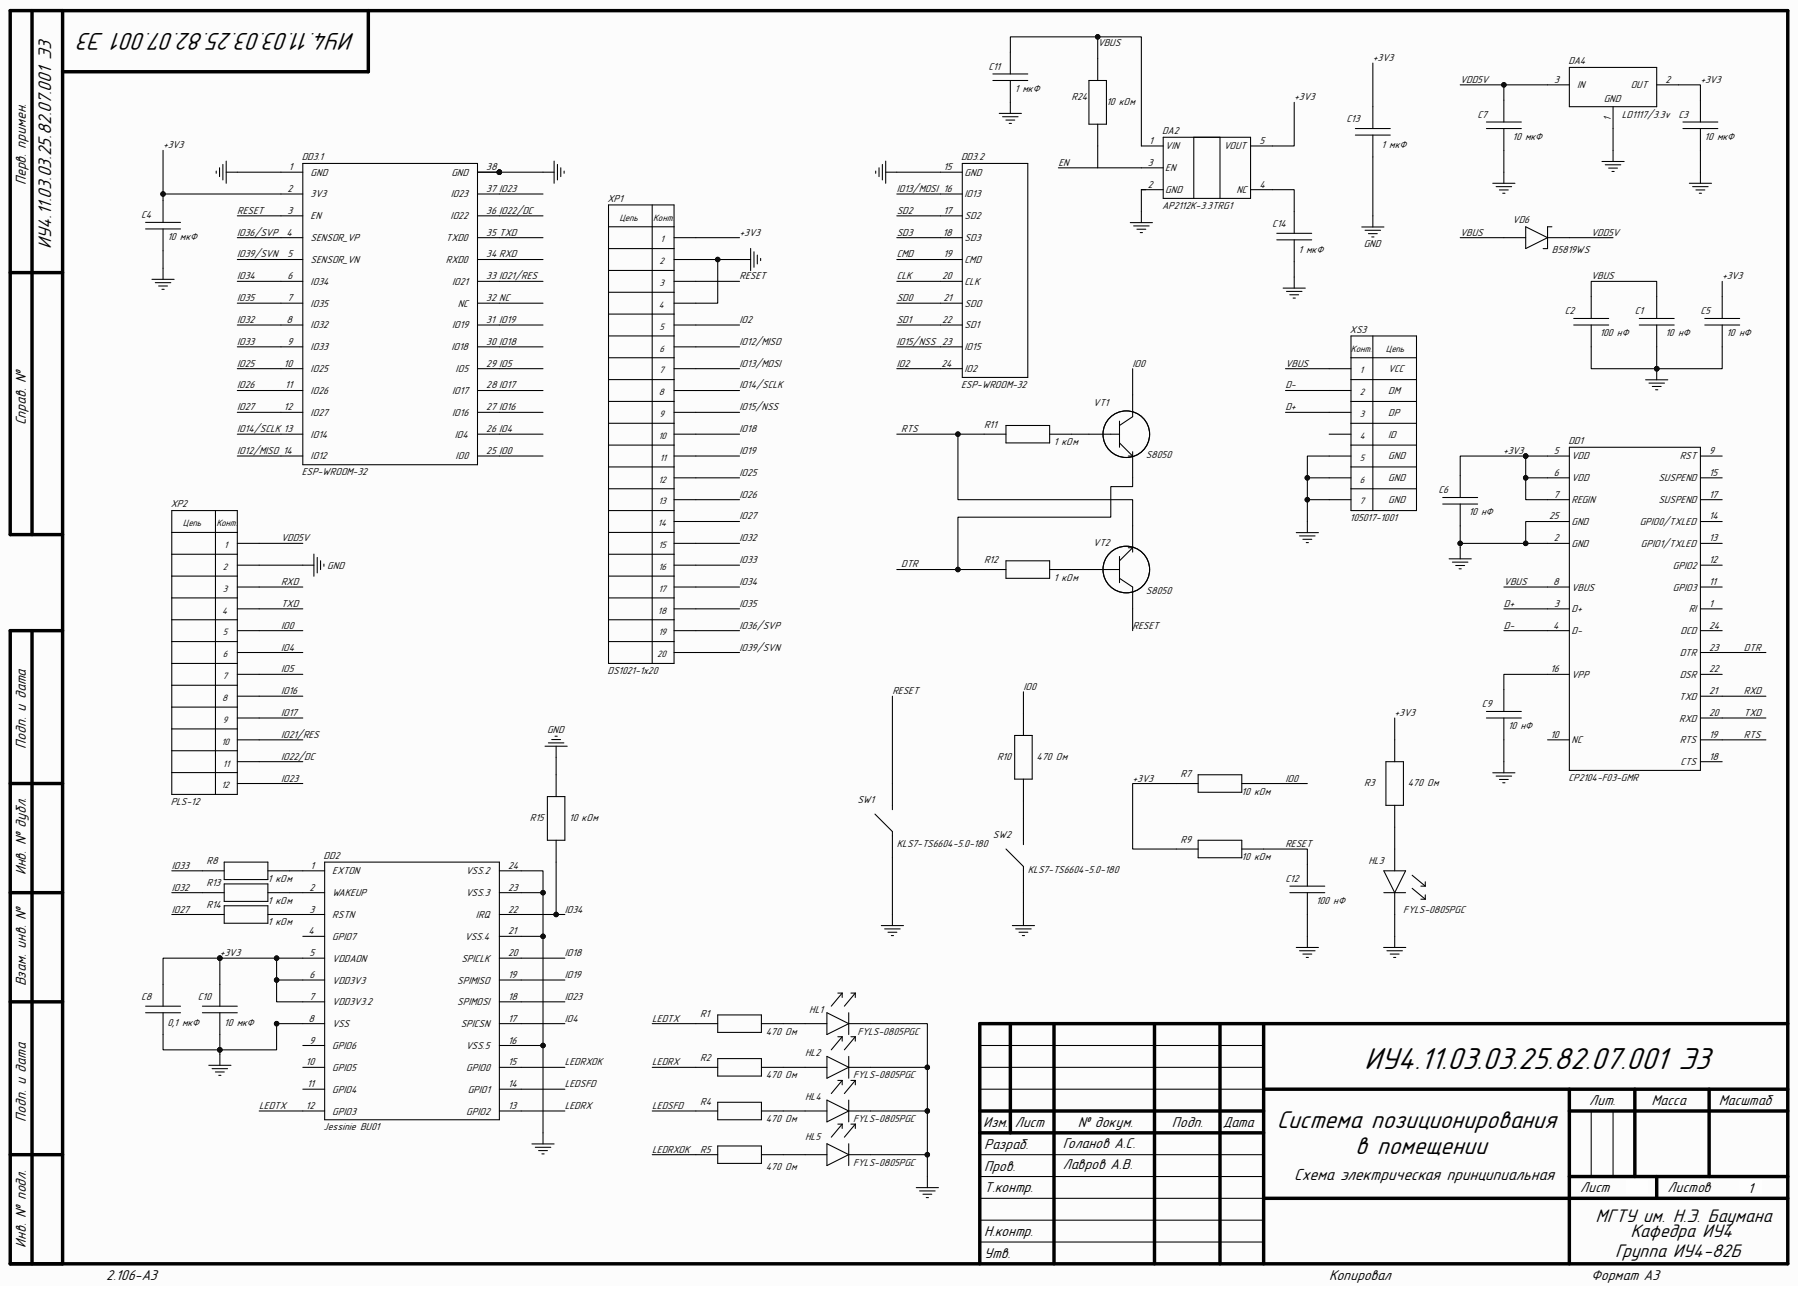
[picture p27: page 1]

Инв. № подл. Инв. № дубл. Подп. и дата Взам. инв. № Подп. и дата Перв. примен. Справ. №

VIN EN GND | VOUT NC

Цепь | Конт.

Изм. | Лист | № докум. | Подп. | Дата
Разраб. | | Голанов А.С.
Пров. | | Лавров А.В.
Т.контр. | | | | | Лист 1 | Листов 3 1

МГТУ им. Н.Э. Баумана Кафедра ИУ4 Группа ИУ4-82Б

Н.контр.
Утв.
