golanovas/Diplom-Help/Голанов_А.С._ИУ4-82Б_ВКРБ_ПП.pdf

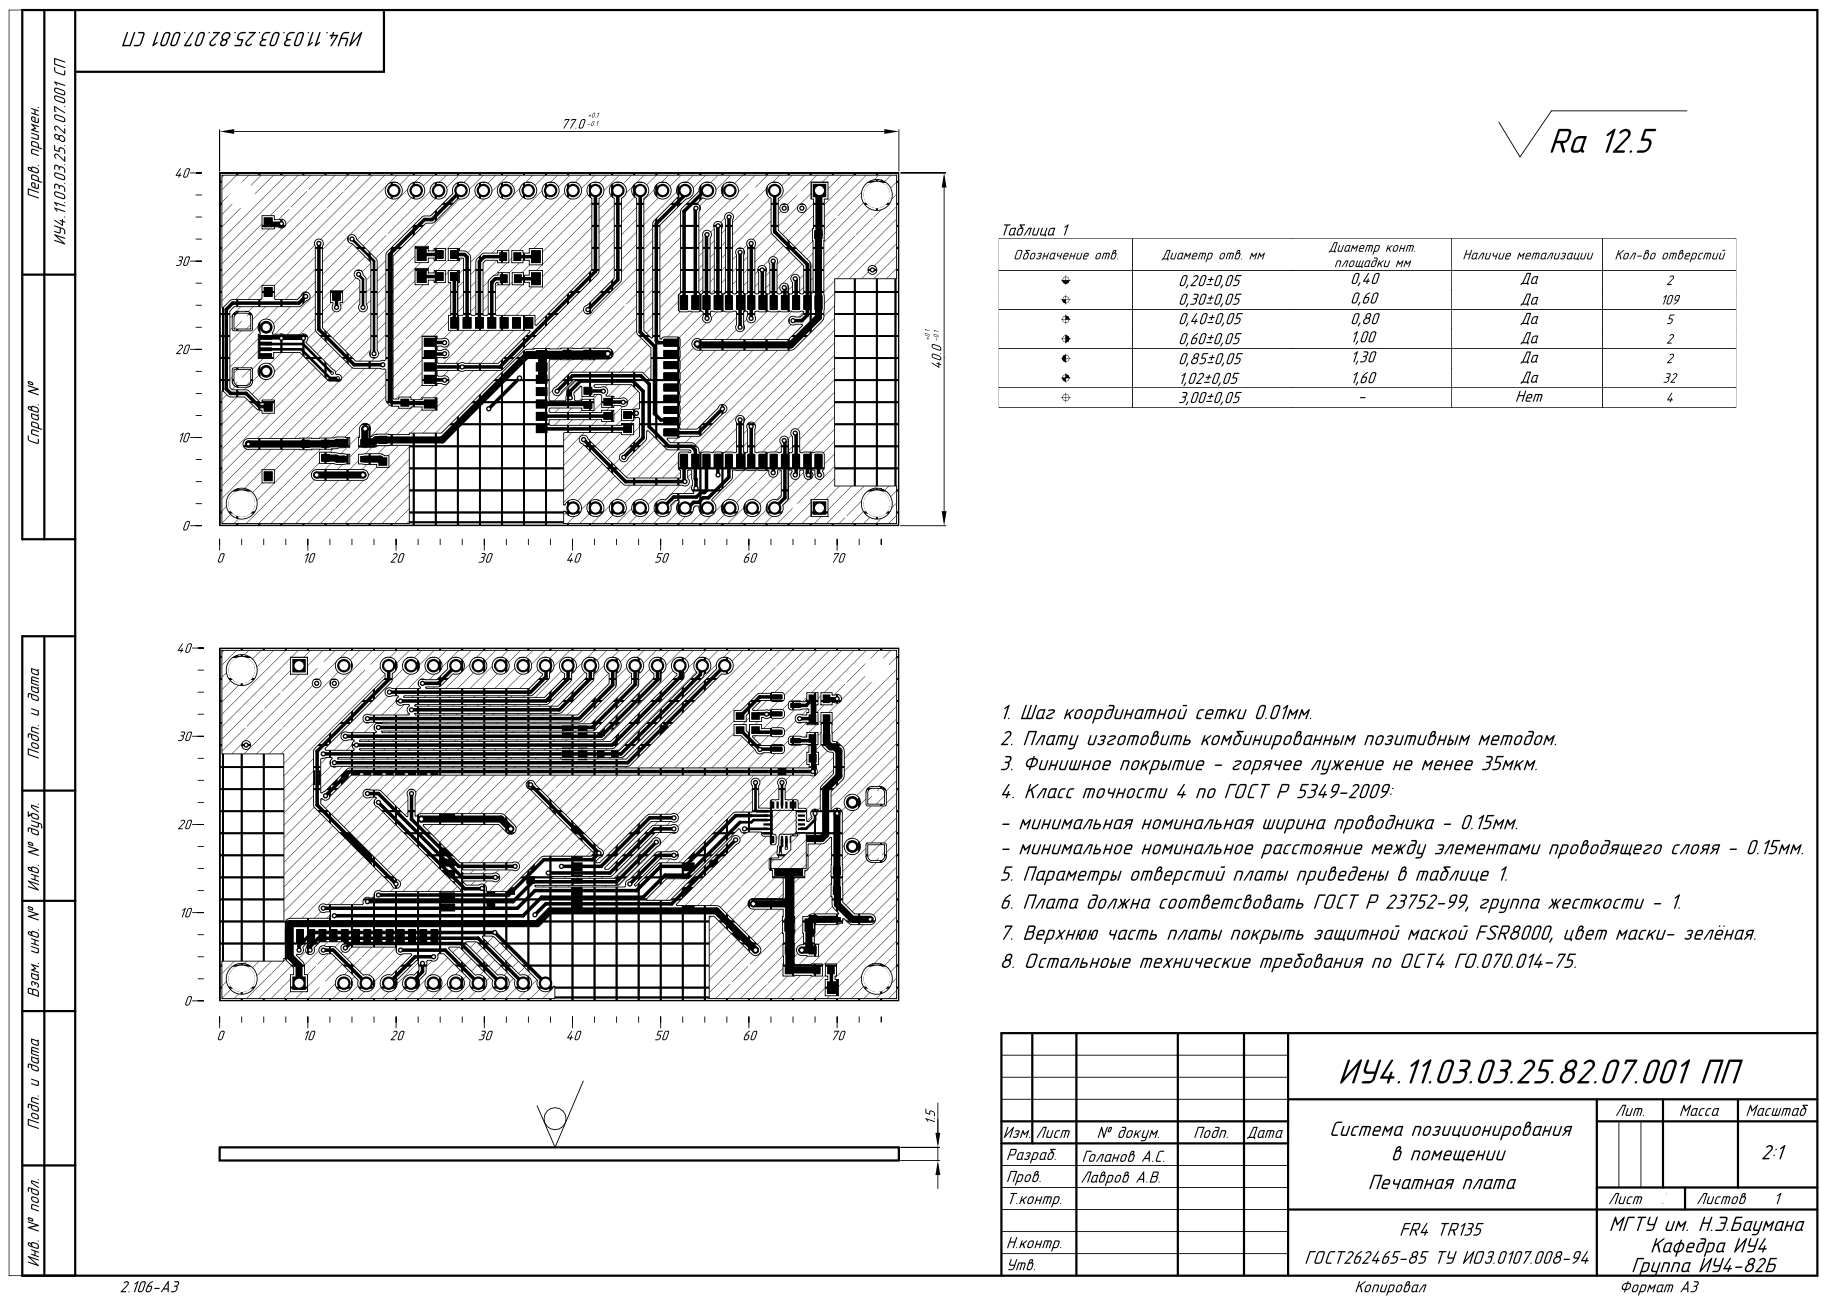
[picture p28: page 1]
