golanovas/Diplom-Help/Голанов_А.С._ИУ4-82Б_ВКРБ_СБ.pdf

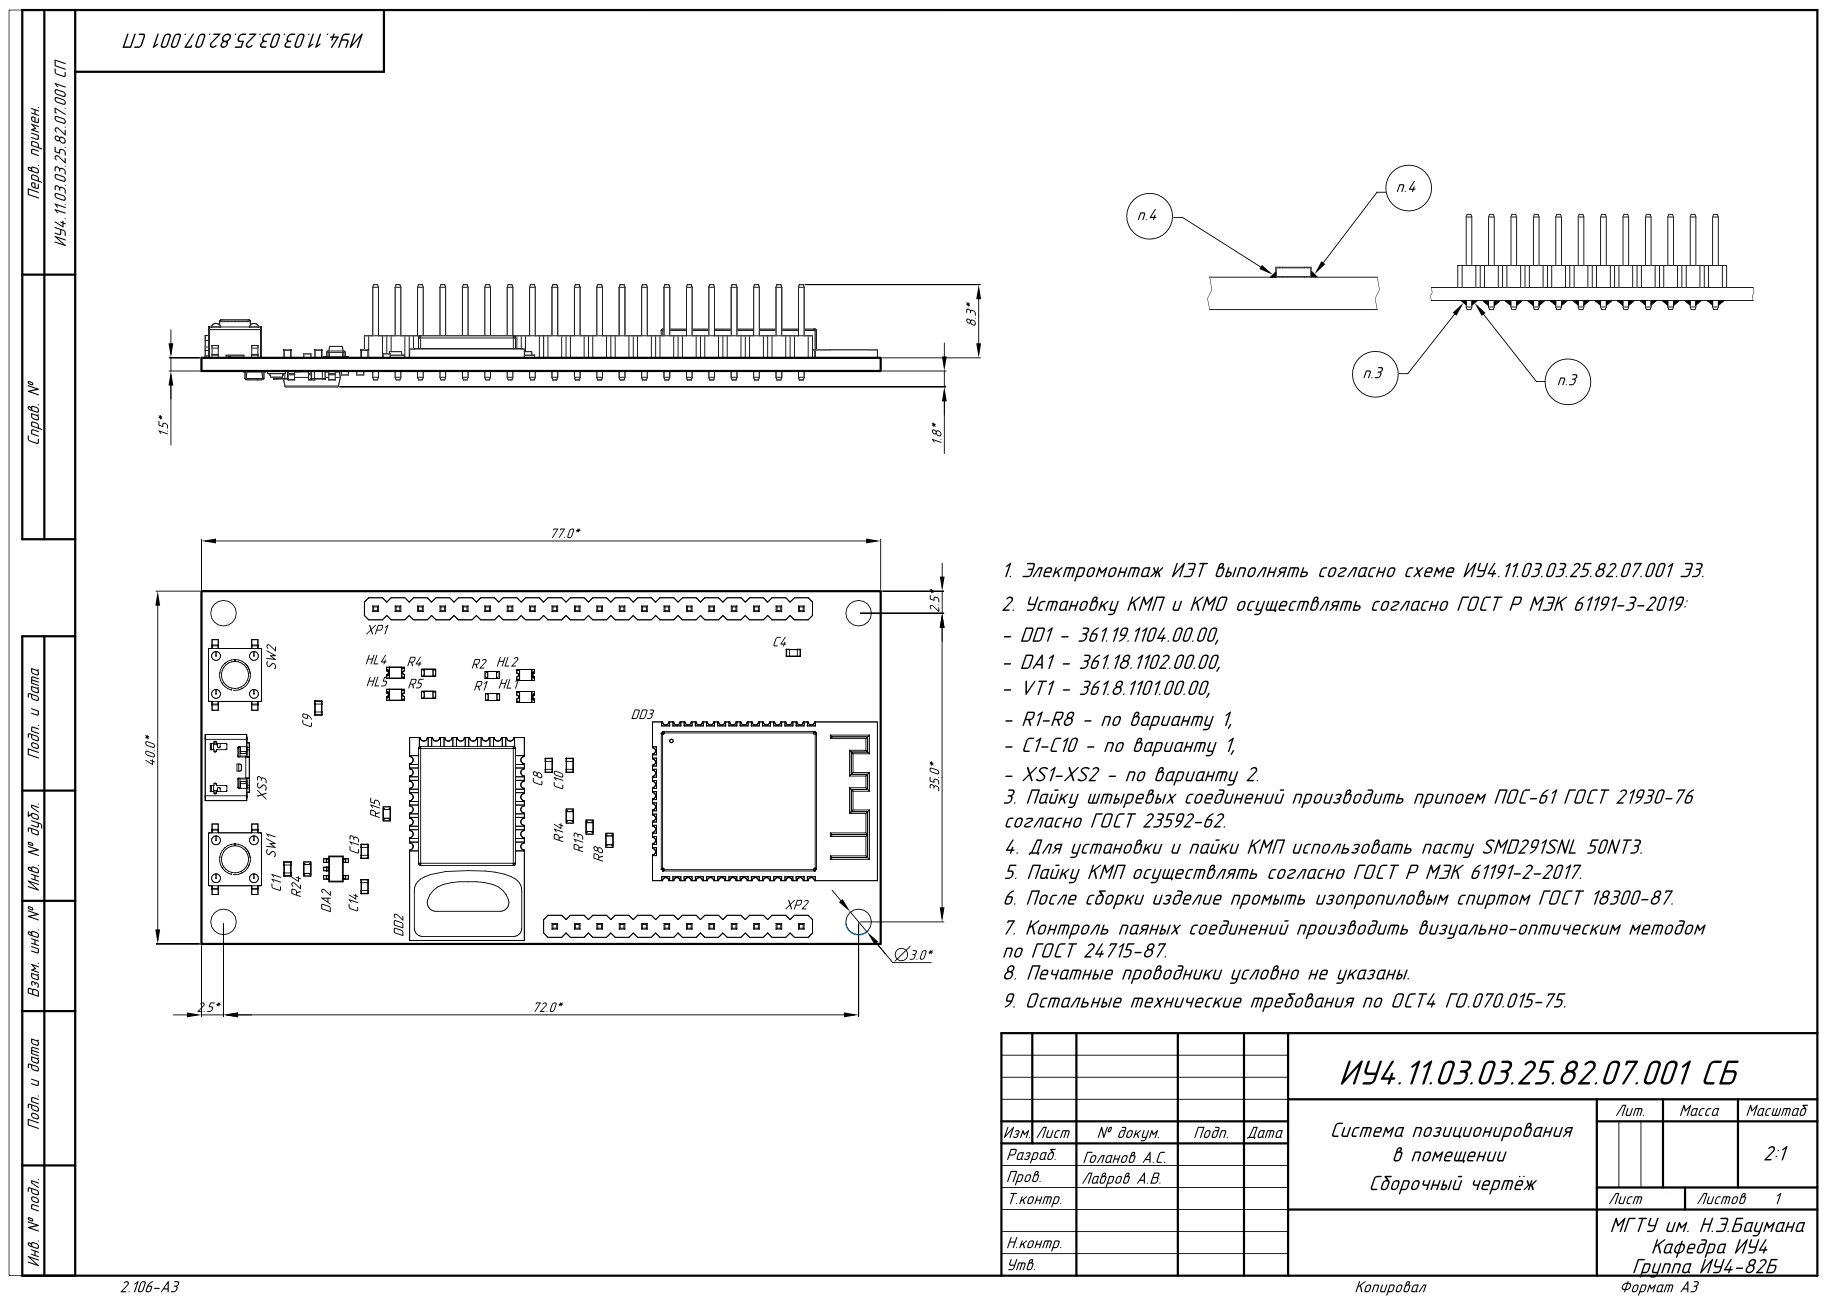
[picture p29: page 1]
